lenafee/Arduino-Guitar-Amp/Pictures/Prototype Pictures/AmpElectronic.jpeg

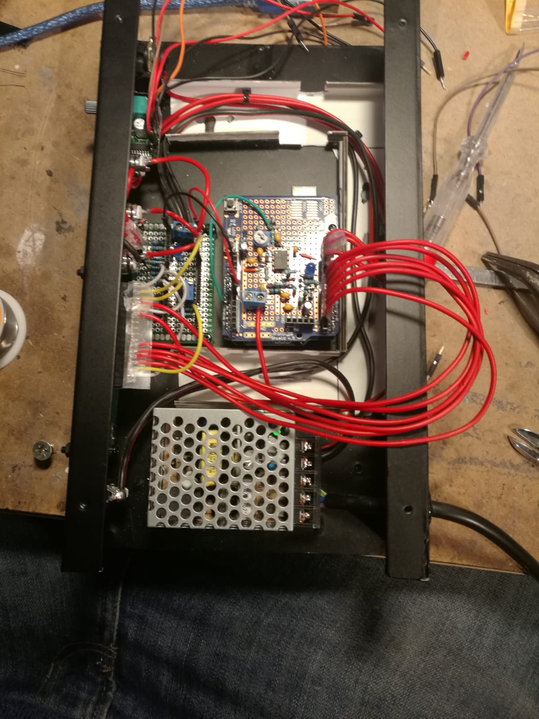
Pictures/Prototype Pictures/AmpElectronic.jpeg
