lenafee/Arduino-Guitar-Amp/Pictures/ArduinoGuitarAmp (11).jpeg

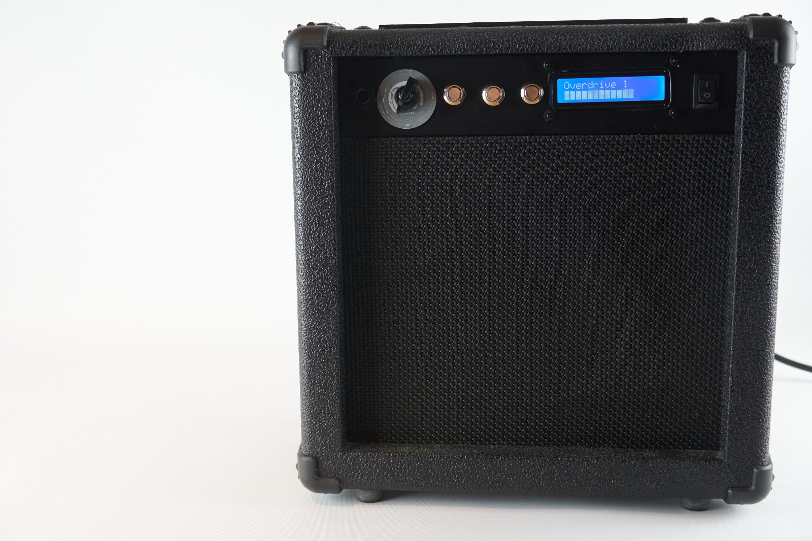
Pictures/ArduinoGuitarAmp (11).jpeg
