lenafee/Arduino-Guitar-Amp/Slides/Vortrag_GitarrenVerstaerker_Folien.pdf

# Arduino Gitarrenverstärker

# Sönke Beyer

### Fachhochschule Kiel

### soenke.t.beyer@student.fh-kiel.de

# May 25, 2020

Sönke Beyer (FH-Kiel) | CTAG | May 25, 2020 | 1 / 18

# Arduino Gitarrenverstärker

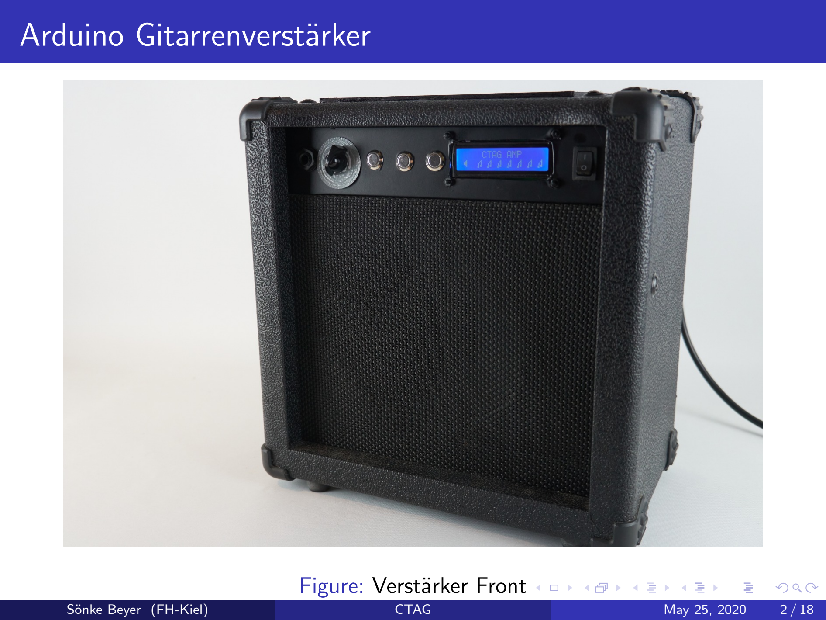
[picture p3: page 2]

## Figure: Verstärker Front

Sönke Beyer (FH-Kiel) | CTAG | May 25, 2020 | 2 / 18

# Arduino Gitarrenverstärker

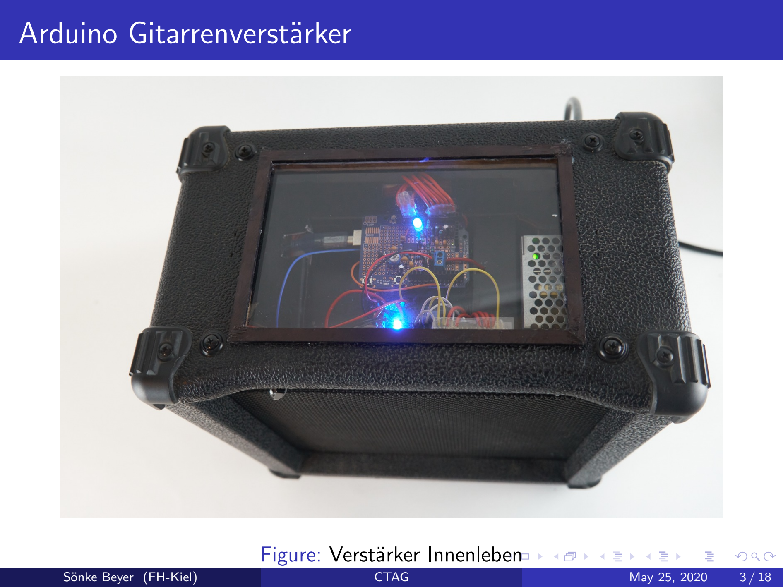
[picture p4: page 3]

## Figure: Verstärker Innenleben

Sönke Beyer (FH-Kiel) | CTAG | May 25, 2020 | 3 / 18

# Arduino Gitarrenverstärker

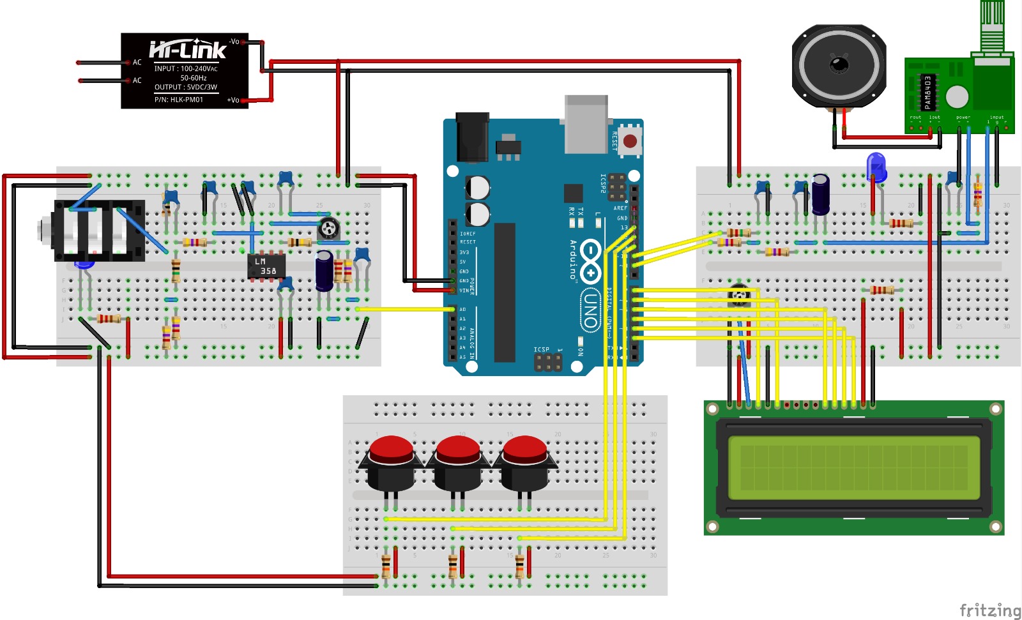
[picture p5: figure]

## Figure: Schaltplan (Erstellt mit Fritzing)

Sönke Beyer (FH-Kiel) | CTAG | May 25, 2020 | 4 / 18

# Stromversorgung

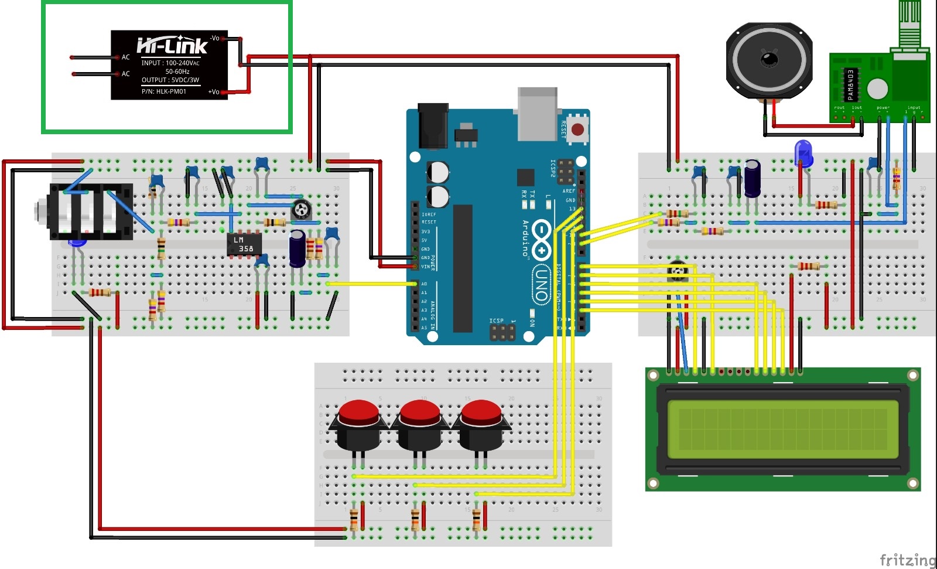
[picture p6: figure]

## Figure: Schaltplan (Erstellt mit Fritzing)

Sönke Beyer (FH-Kiel) | CTAG | May 25, 2020 | 5 / 18

# Signal Input

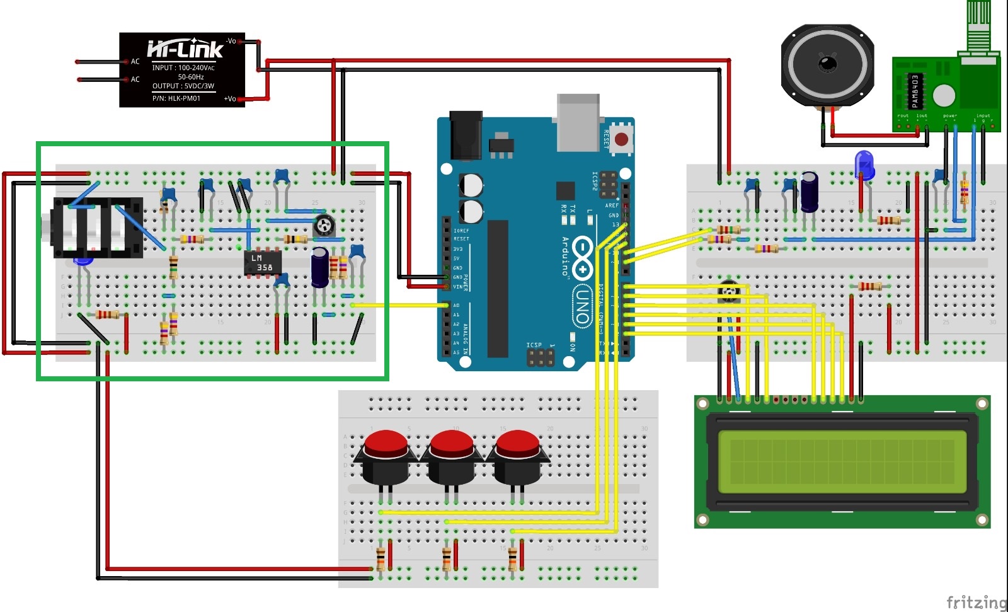
[picture p7: figure]

## Figure: Schaltplan (Erstellt mit Fritzing)

Sönke Beyer (FH-Kiel) | CTAG | May 25, 2020 | 6 / 18

# Arduino

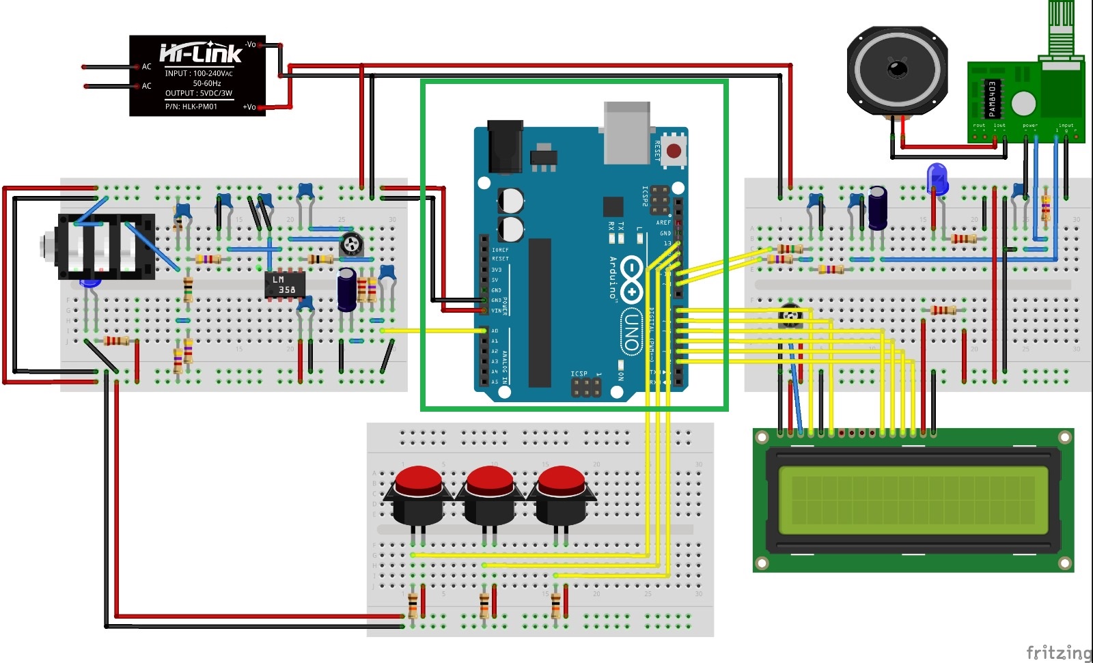
[picture p8: figure]

## Figure: Schaltplan (Erstellt mit Fritzing)

Sönke Beyer (FH-Kiel) | CTAG | May 25, 2020 | 7 / 18

# Signal Output

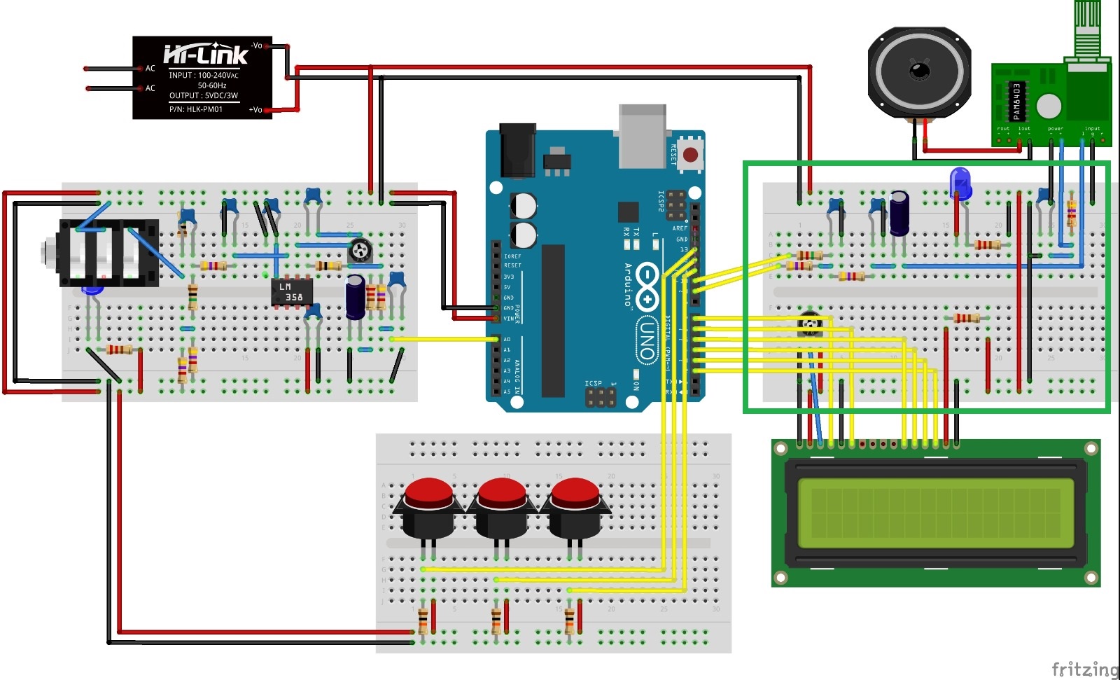
[picture p9: figure]

## Figure: Schaltplan (Erstellt mit Fritzing)

Sönke Beyer (FH-Kiel) | CTAG | May 25, 2020 | 8 / 18

# Lautsprecher, Class D Amp

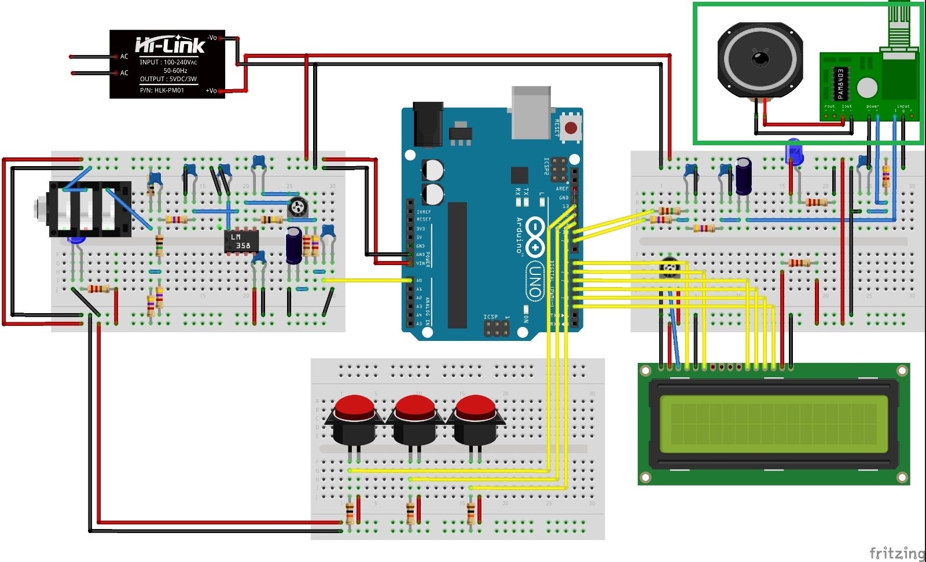
[picture p10: figure]

## Figure: Schaltplan (Erstellt mit Fritzing)

Sönke Beyer (FH-Kiel) | CTAG | May 25, 2020 | 9 / 18

# Bildschirm und Schalter

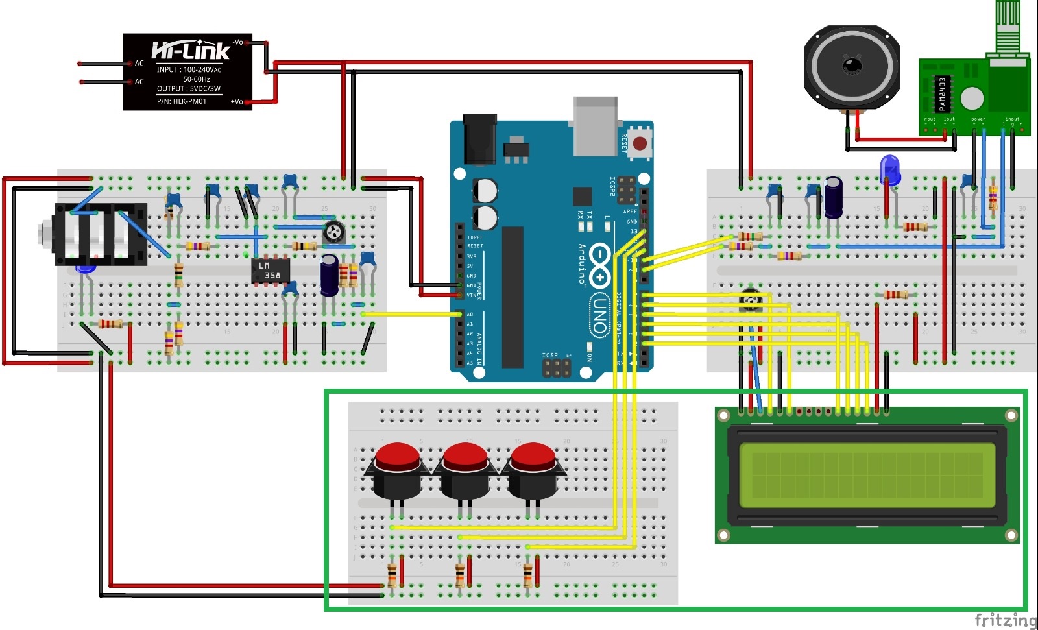
[picture p11: figure]

## Figure: Schaltplan (Erstellt mit Fritzing)

Sönke Beyer (FH-Kiel) | CTAG | May 25, 2020 | 10 / 18

# Ablauf Software

# Example (setup)

## void setup(){ Start Display Konfiguriert Buttons Konfiguriert ADC/DAC

}

Sönke Beyer (FH-Kiel) | CTAG | May 25, 2020 | 11 / 18

# Ablauf Software

# Example (loop)

## void loop(){

## Bearbeite Button Inputs Erstellt Bildschirmausgabe Aktiviert/Deaktiviert Effekte Zuständig für Level der Effekte delay(200) für Workload

}

Sönke Beyer (FH-Kiel) | CTAG | May 25, 2020 | 12 / 18

# Ablauf Software

# Example (ISR)

## void ISR(){ Liest ADCSignal Fügt die Effekte dem Signal hinzu Gebe Signal an PWM

}

Sönke Beyer (FH-Kiel) | CTAG | May 25, 2020 | 13 / 18

# Herangehensweise

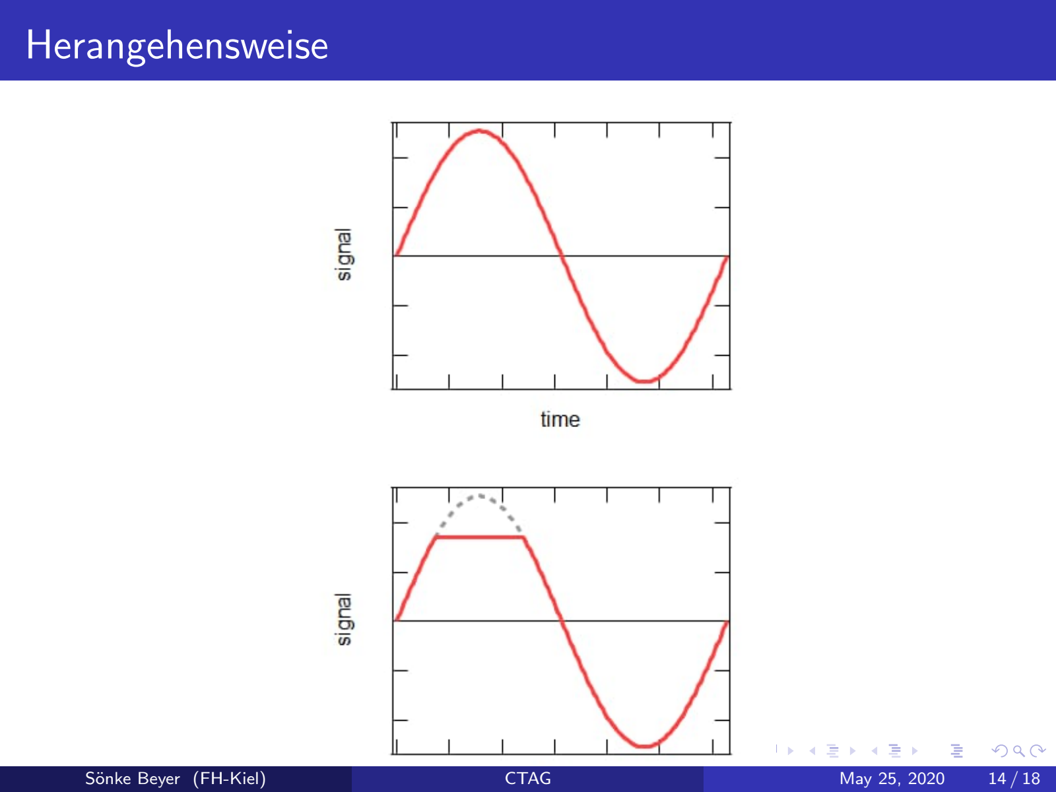
[picture p12: page 14]

Sönke Beyer (FH-Kiel) | CTAG | May 25, 2020 | 14 / 18

# Effekt Beispiel

# Example (Overdrive)

## //This overdrive uses hard clipping only on the top void positiveHalfHardClipping(int level, int *input){ if(*input > level){

*input = level;
}
}
Sönke Beyer (FH-Kiel) | CTAG | May 25, 2020 | 15 / 18

# Erstellen von Effenkten

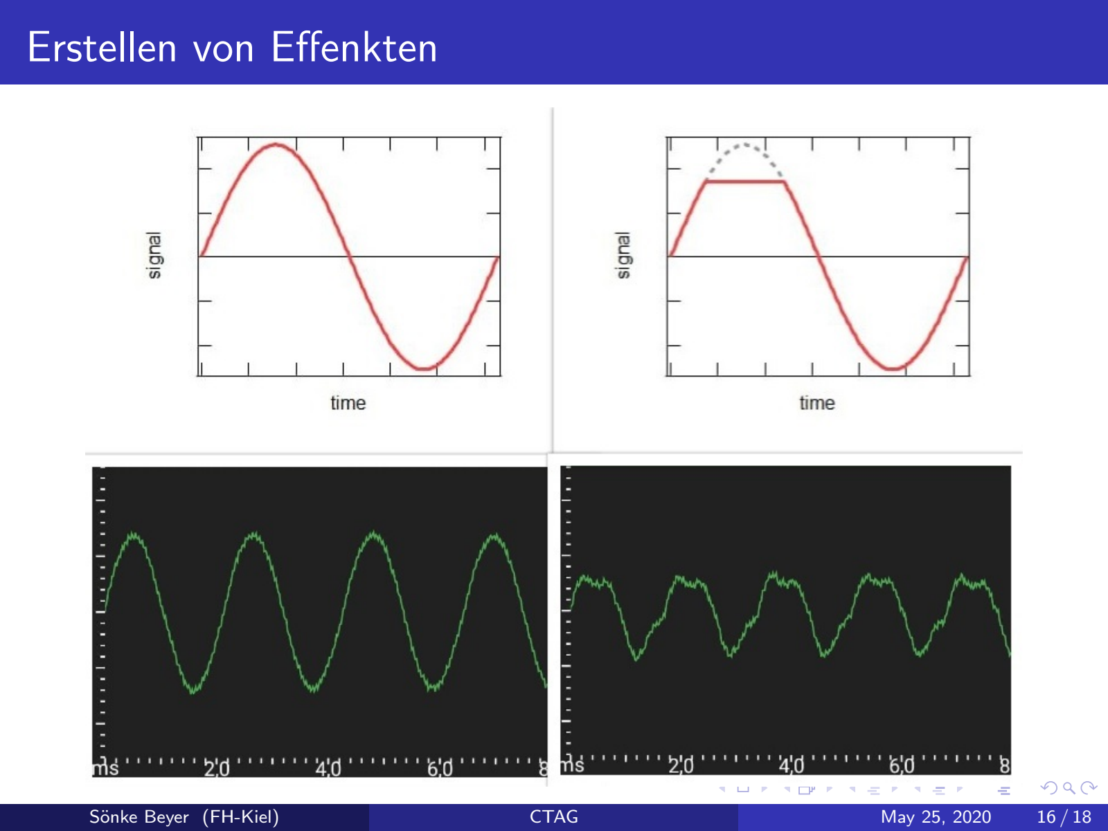
[picture p13: page 16]

## Figure: Schaltplan (Erstellt mit Igor Pro/)

Sönke Beyer (FH-Kiel) | CTAG | May 25, 2020 | 16 / 18

# Effekte

# Volume

# Boost

# 5x Overdrive

# 2x Distorsion

# Reverb

# 2x Tremolo

# 2x Waveform Generator

Sönke Beyer (FH-Kiel) | CTAG | May 25, 2020 | 17 / 18

# Demonstration

# Youtube Video: Video Demonstration. (https://www.youtube.com/watch?v=WST0WDY9Kv4)

Sönke Beyer (FH-Kiel) | CTAG | May 25, 2020 | 18 / 18
