lenafee/Arduino-Guitar-Amp/Pictures/ArduinoGuitarAmp (2).jpeg

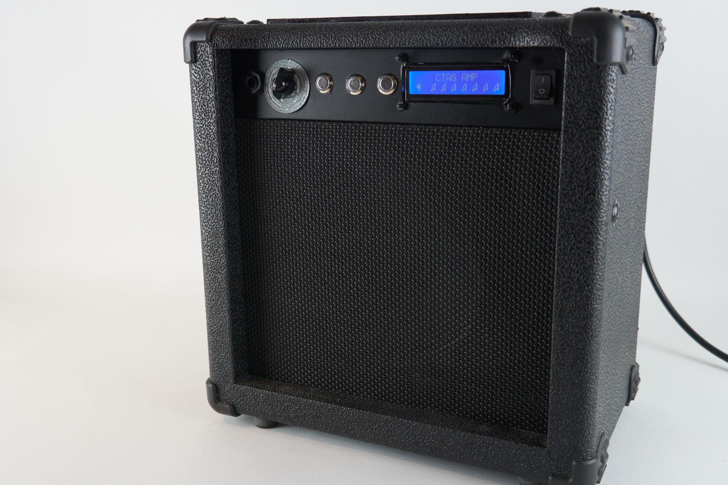
Pictures/ArduinoGuitarAmp (2).jpeg
