lenafee/Arduino-Guitar-Amp/Pictures/ArduinoGuitarAmp (4).jpeg

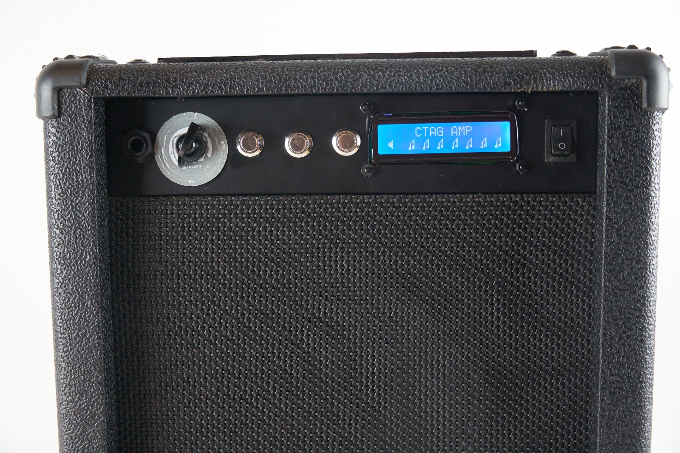
Pictures/ArduinoGuitarAmp (4).jpeg
