lenafee/Arduino-Guitar-Amp/Pictures/ArduinoGuitarAmp (5).jpeg

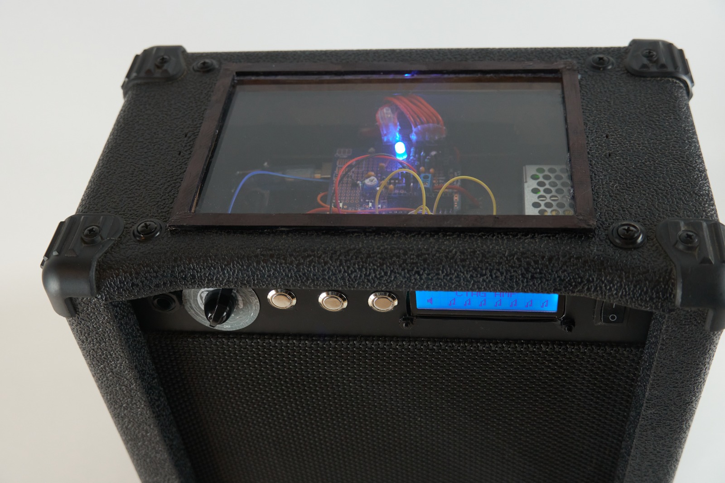
Pictures/ArduinoGuitarAmp (5).jpeg
