lenafee/Arduino-Guitar-Amp/Pictures/ArduinoGuitarAmp (6).jpeg

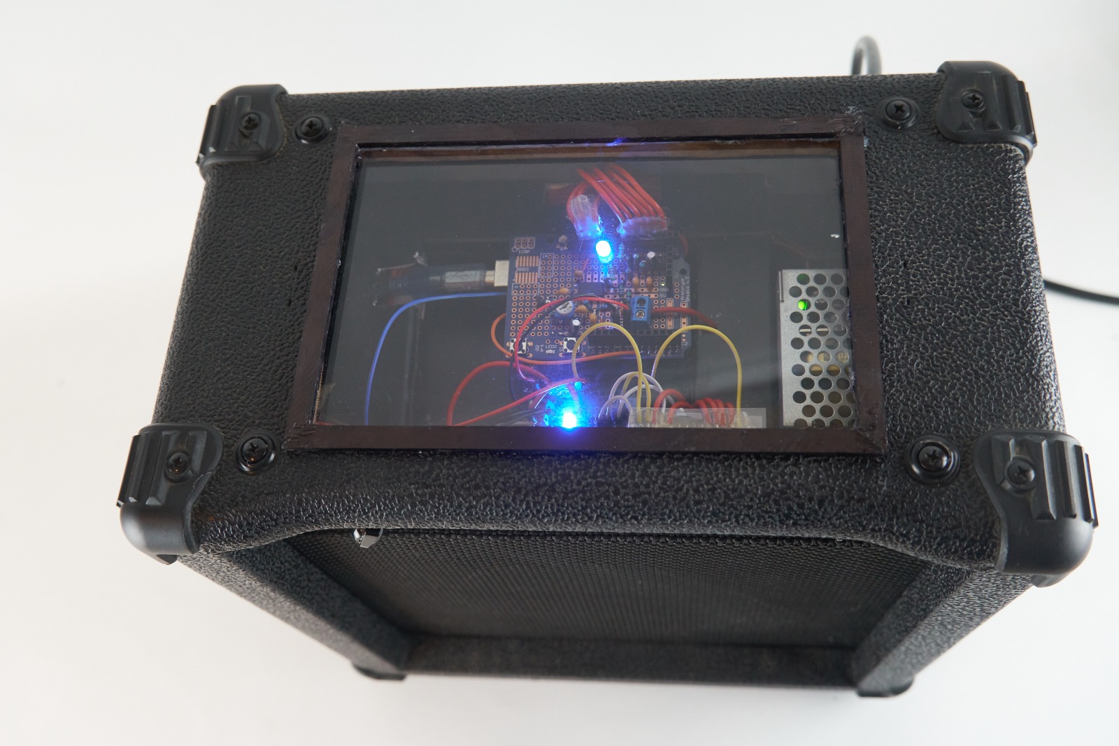
Pictures/ArduinoGuitarAmp (6).jpeg
