lenafee/Arduino-Guitar-Amp/Pictures/ArduinoGuitarAmp (7).jpeg

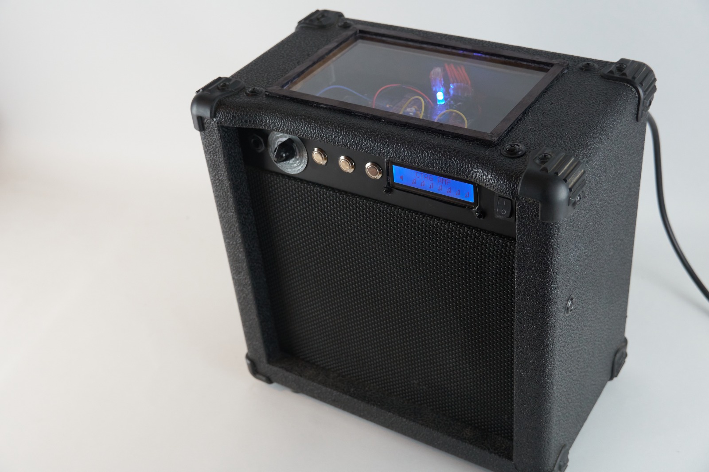
Pictures/ArduinoGuitarAmp (7).jpeg
