lenafee/Arduino-Guitar-Amp/Pictures/ArduinoGuitarAmp (10).jpeg

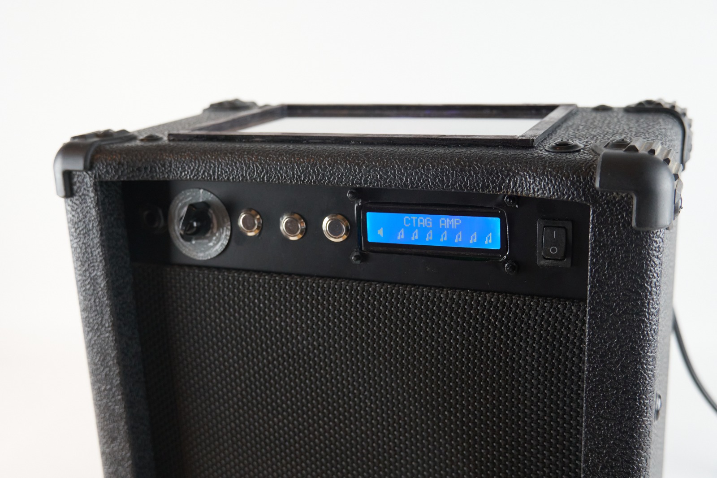
Pictures/ArduinoGuitarAmp (10).jpeg
