lenafee/Arduino-Guitar-Amp/Pictures/ArduinoGuitarAmp (12).jpeg

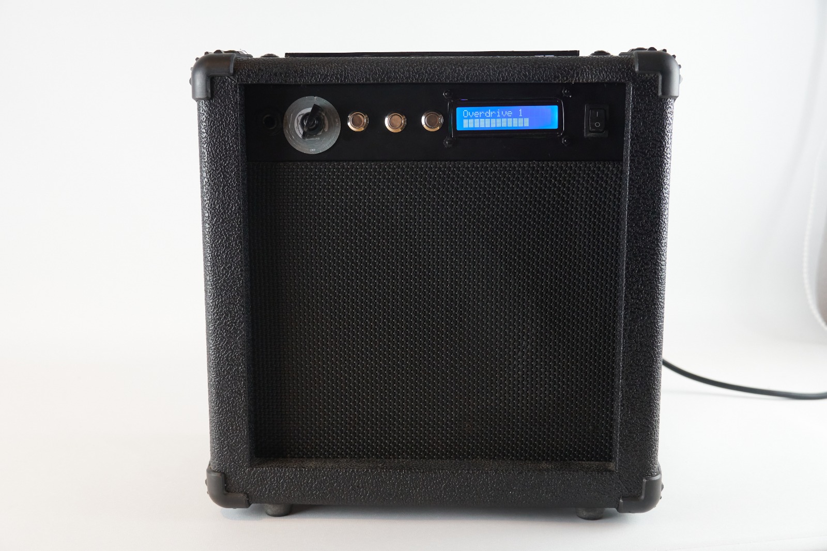
Pictures/ArduinoGuitarAmp (12).jpeg
