lenafee/Arduino-Guitar-Amp/Pictures/ArduinoGuitarAmp (13).jpeg

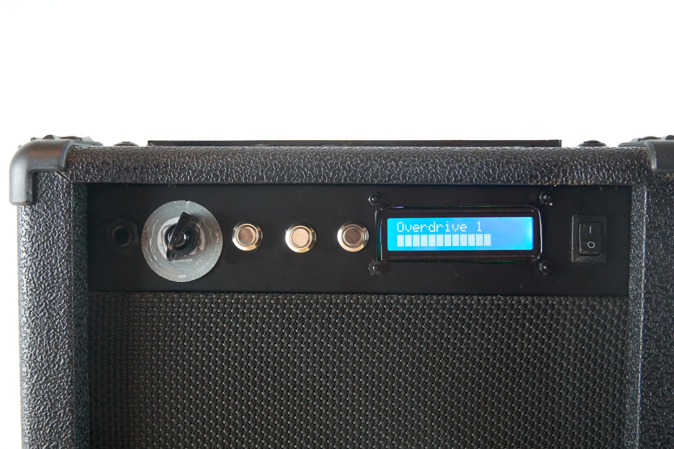
Pictures/ArduinoGuitarAmp (13).jpeg
