lenafee/Arduino-Guitar-Amp/Pictures/ArduinoGuitarAmp (14).jpeg

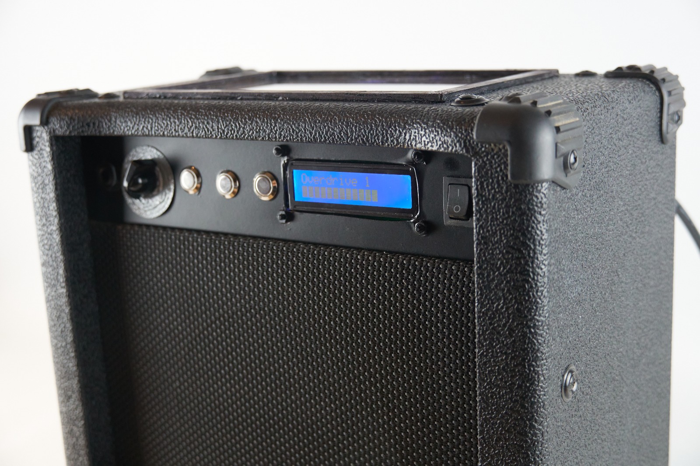
Pictures/ArduinoGuitarAmp (14).jpeg
