lenafee/Arduino-Guitar-Amp/Pictures/ArduinoGuitarAmp (15).jpeg

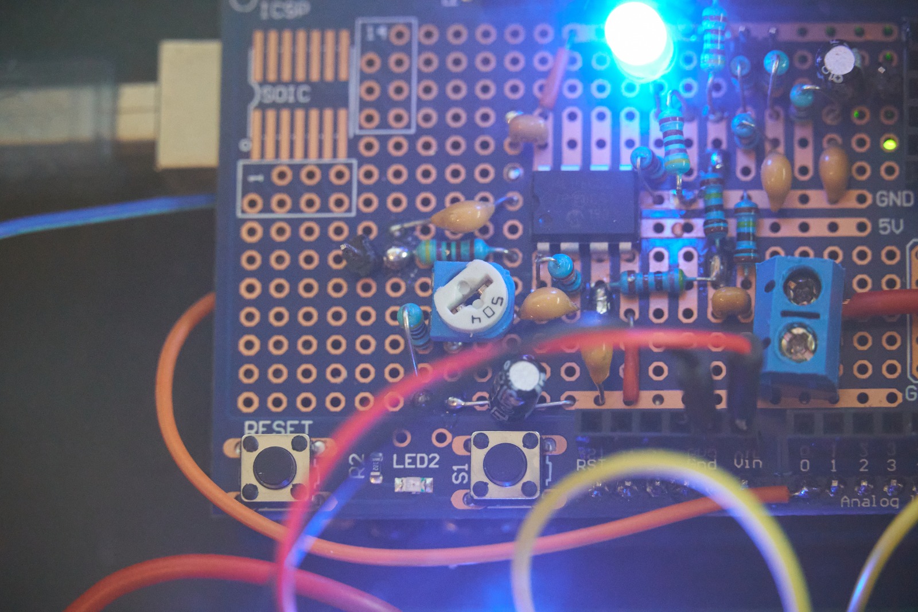
Pictures/ArduinoGuitarAmp (15).jpeg
