lenafee/Arduino-Guitar-Amp/Pictures/ArduinoGuitarAmp (16).jpeg

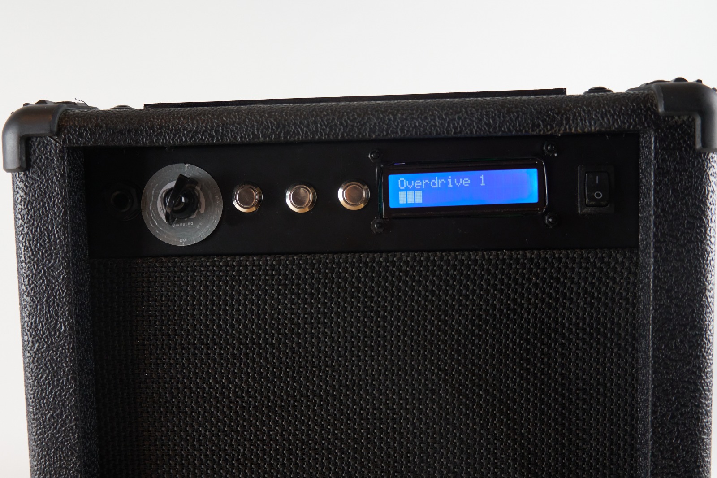
Pictures/ArduinoGuitarAmp (16).jpeg
