lenafee/Arduino-Guitar-Amp/Pictures/ArduinoGuitarAmp (17).jpeg

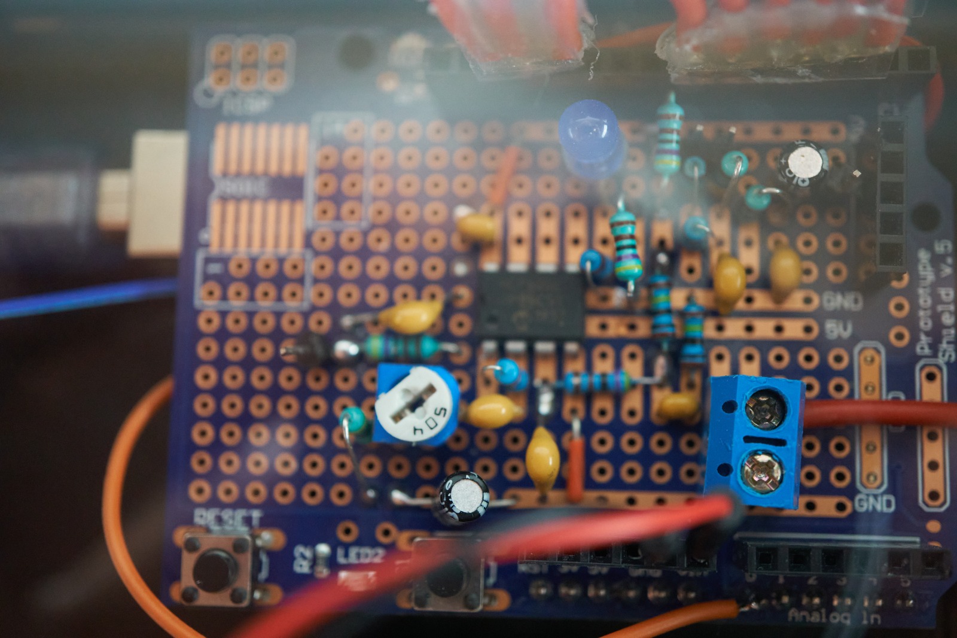
Pictures/ArduinoGuitarAmp (17).jpeg
