lenafee/Arduino-Guitar-Amp/Pictures/ArduinoGuitarAmp (20).jpeg

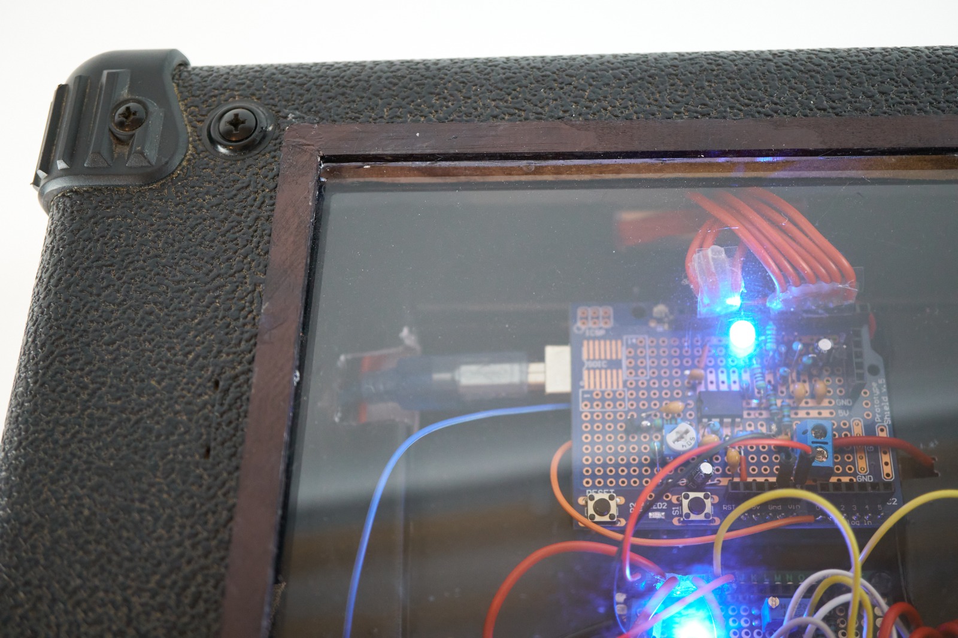
Pictures/ArduinoGuitarAmp (20).jpeg
