lenafee/Arduino-Guitar-Amp/Pictures/Prototype Pictures/AmpBeforeClose.jpeg

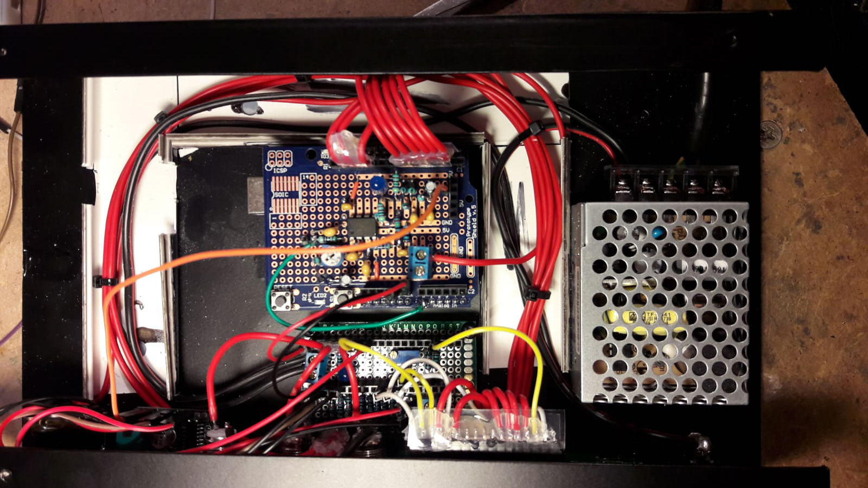
Pictures/Prototype Pictures/AmpBeforeClose.jpeg
