lenafee/Arduino-Guitar-Amp/Pictures/Prototype Pictures/AmpCase.jpeg

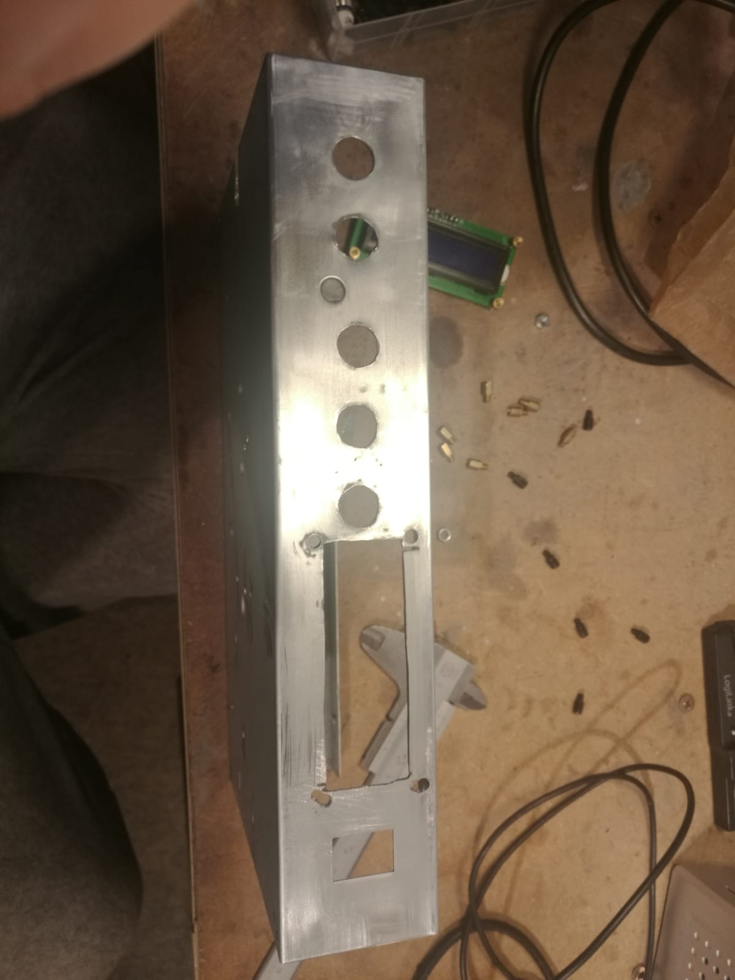
Pictures/Prototype Pictures/AmpCase.jpeg
