lenafee/Arduino-Guitar-Amp/Pictures/Prototype Pictures/DisplayCut.jpeg

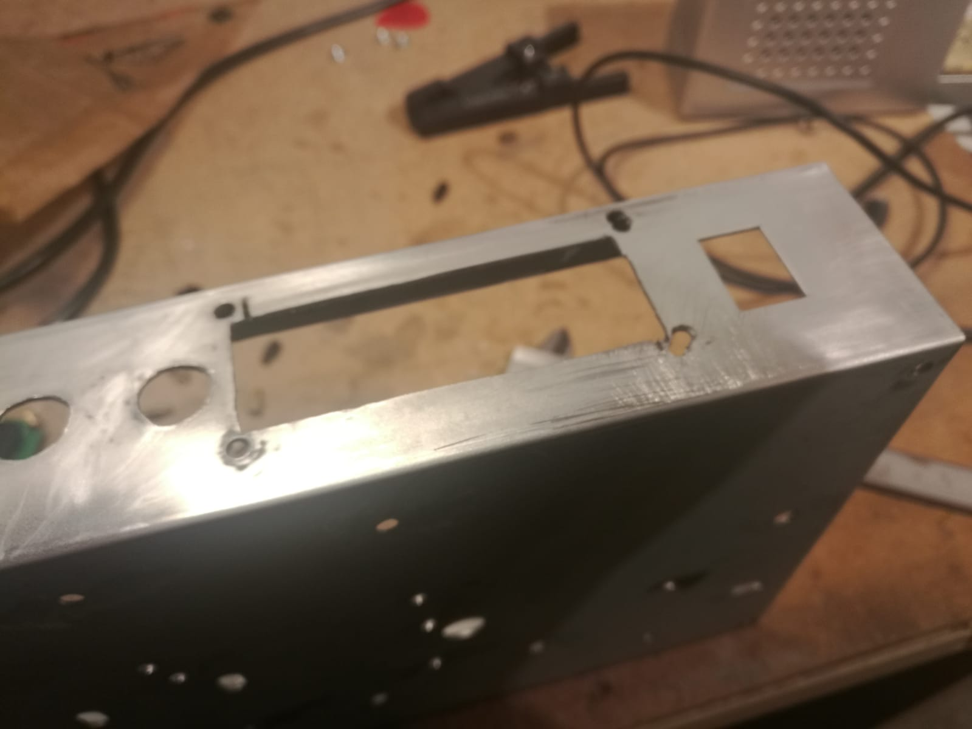
Pictures/Prototype Pictures/DisplayCut.jpeg
