lenafee/Arduino-Guitar-Amp/Pictures/Prototype Pictures/PrototypeBoard.jpeg

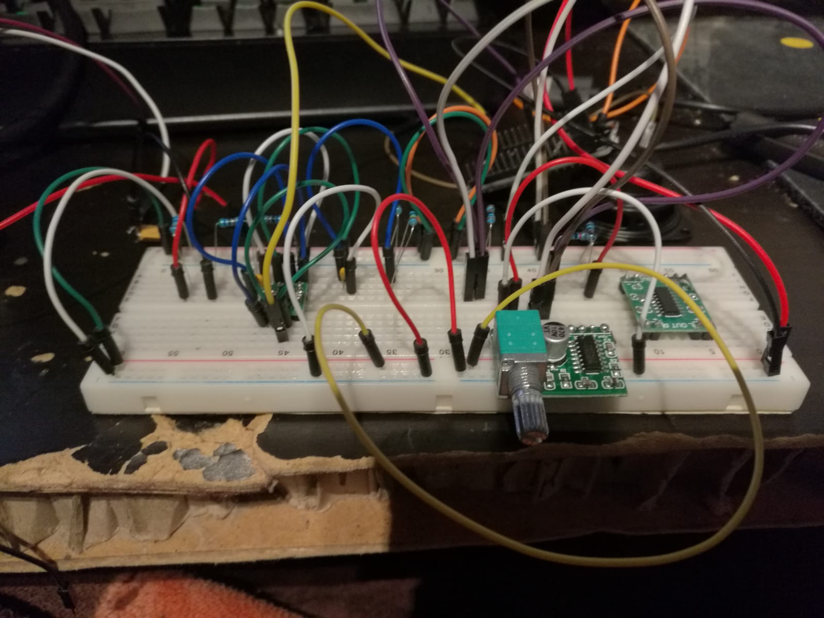
Pictures/Prototype Pictures/PrototypeBoard.jpeg
