lenafee/Arduino-Guitar-Amp/Arduino_Guitar_Amp/specialSounds.h

//This file contains the experimental sounds and effects.
void crazySound(){
    delay(8);
}

int sinWaveCounter = 0;
int triWaveCounter = 0;

//Sin waveform template
//created with https://www.daycounter.com/Calculators/Sine-Generator-Calculator.phtml
const byte sinWave[] = {
      0x1388,0x13a7,0x13c5,0x13e4,0x1403,0x1422,0x1440,0x145f,
    0x147e,0x149c,0x14bb,0x14da,0x14f8,0x1517,0x1535,0x1554,
    0x1573,0x1591,0x15b0,0x15ce,0x15ed,0x160b,0x162a,0x1648,
    0x1666,0x1685,0x16a3,0x16c1,0x16e0,0x16fe,0x171c,0x173a,
    0x1758,0x1776,0x1795,0x17b3,0x17d1,0x17ef,0x180c,0x182a,
    0x1848,0x1866,0x1884,0x18a1,0x18bf,0x18dc,0x18fa,0x1917,
    0x1935,0x1952,0x196f,0x198d,0x19aa,0x19c7,0x19e4,0x1a01,
    0x1a1e,0x1a3b,0x1a58,0x1a74,0x1a91,0x1aae,0x1aca,0x1ae7,
    0x1b03,0x1b20,0x1b3c,0x1b58,0x1b74,0x1b90,0x1bac,0x1bc8,
    0x1be4,0x1bff,0x1c1b,0x1c37,0x1c52,0x1c6d,0x1c89,0x1ca4,
    0x1cbf,0x1cda,0x1cf5,0x1d10,0x1d2b,0x1d45,0x1d60,0x1d7a,
    0x1d95,0x1daf,0x1dc9,0x1de3,0x1dfd,0x1e17,0x1e31,0x1e4b,
    0x1e64,0x1e7e,0x1e97,0x1eb0,0x1ec9,0x1ee3,0x1efb,0x1f14,
    0x1f2d,0x1f46,0x1f5e,0x1f76,0x1f8f,0x1fa7,0x1fbf,0x1fd7,
    0x1fef,0x2006,0x201e,0x2035,0x204c,0x2064,0x207b,0x2092,
    0x20a8,0x20bf,0x20d6,0x20ec,0x2102,0x2119,0x212f,0x2144,
    0x215a,0x2170,0x2185,0x219b,0x21b0,0x21c5,0x21da,0x21ef,
    0x2203,0x2218,0x222c,0x2241,0x2255,0x2269,0x227d,0x2290,
    0x22a4,0x22b7,0x22ca,0x22de,0x22f0,0x2303,0x2316,0x2328,
    0x233b,0x234d,0x235f,0x2371,0x2383,0x2394,0x23a6,0x23b7,
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
    }

  //Tremolo with triangle waveform
  void tremoloTriangle(int *input){
      triWaveCounter++;
      if(triWaveCounter >= 1000){
          triWaveCounter = 0;
        }
      *input = map(*input,0,6000,0,triangleWave[triWaveCounter]);
    }

  //Creates sin output wave
  void sinWaveFormGenerator(int *input){
      sinWaveCounter++;
      if(sinWaveCounter >= 1000){
          sinWaveCounter = 0;
        }
      *input = sinWave[sinWaveCounter];
    }

  //Creates triangle output wave
  void triWaveFormGenerator(int *input){
      triWaveCounter++;
      if(triWaveCounter >= 1000){
          triWaveCounter = 0;
        }
      *input = triangleWave[triWaveCounter];
    }
