lenafee/Arduino-Guitar-Amp/(commit log)

2020-04-28 Addet the Parts of the Board
    List of the Parts of the Guitar Amp
2020-04-29 addet a couple of distorsion
2020-05-17 Update README.md
    Addet the circuit
